mprice9/Raspberry-PIC-GoPack/README.md

# RaspberryPIC GoPack
A Rapsberry Pi powered prototyping platform for wearable robotics and data acquisition.
