mprice9/Raspberry-PIC-GoPack/GoPack Board Rev A/Pi MCU shield.brd

## EAGLE design GoPack Board Rev A/Pi MCU shield.brd (2017-01-17)

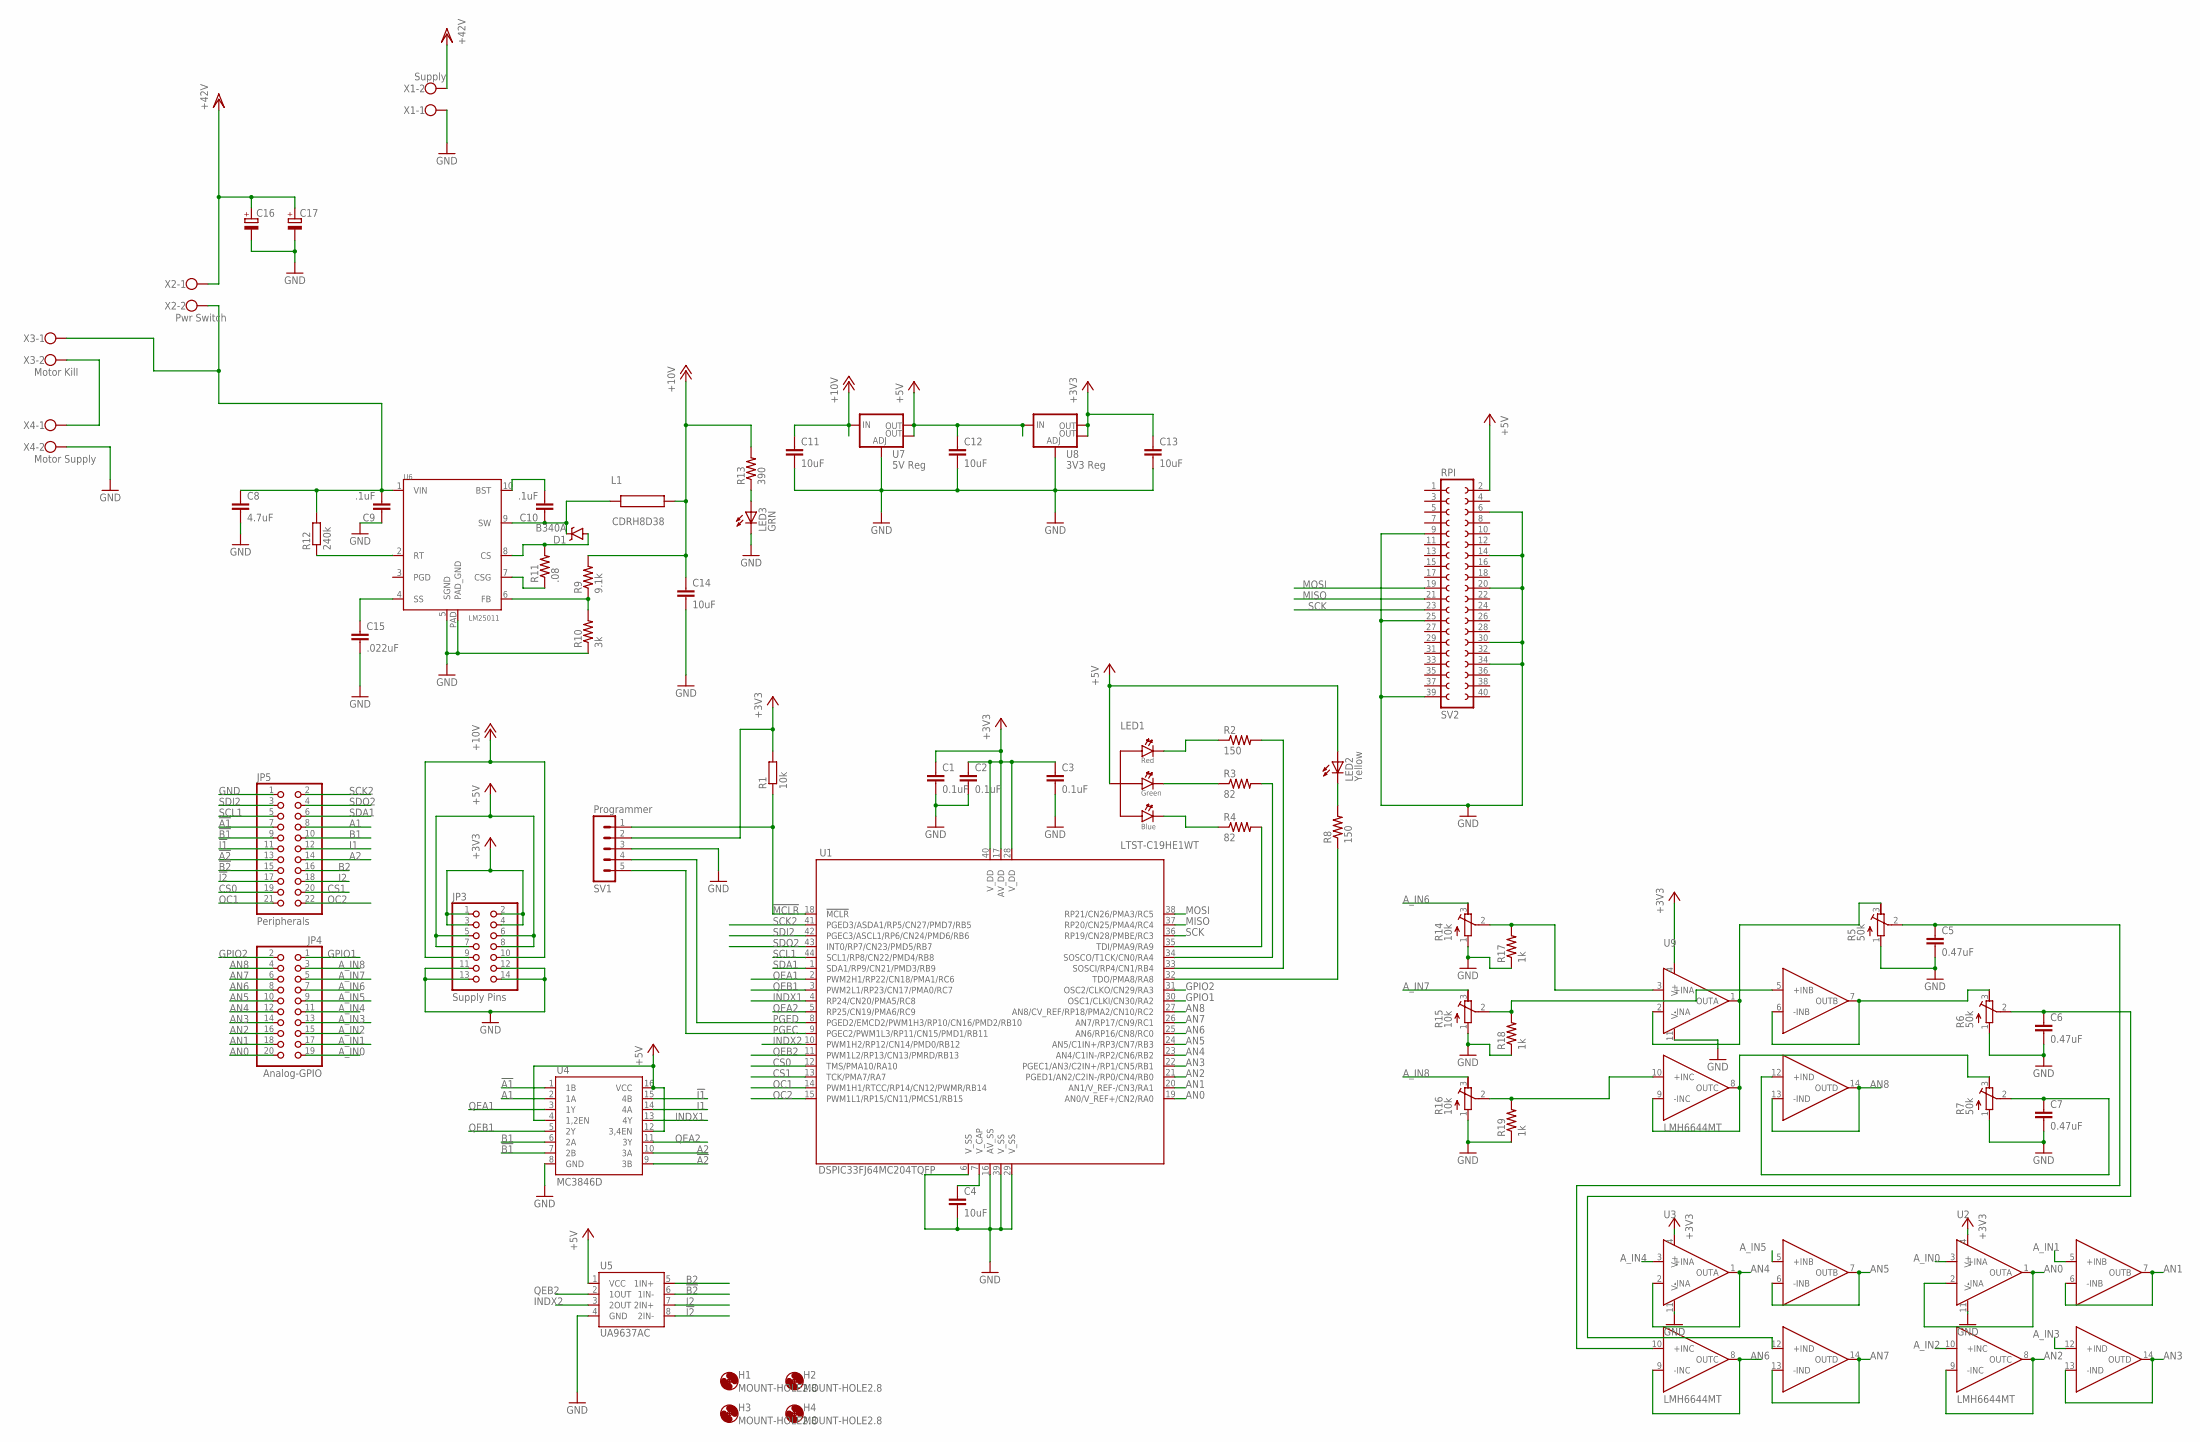
[picture p1: schematic Pi MCU shield.sch]

Parts:
C1, C2, C3: 0.1uF; C0603
C4, C14: 10uF; C1206
C5, C6, C7: 0.47uF; C0603
C8: 4.7uF; C1210
C9, C10: .1uF; 0603-CAP
C11, C12, C13: 10uF; C0805
C15: .022uF; 0603-CAP
C16, C17: CPOL-EUE5-13; E5-13
D1: B340A; SMA-DIODE
H1, H2, H3, H4: MOUNT-HOLE2.8; 2,8
JP3: Supply Pins; 2X07
JP4: Analog-GPIO; 2X10
JP5: Peripherals; 2X11
L1: CDRH8D38
LED1: LTST-C19HE1WT; 0606
LED2: Yellow; SML0603
LED3: GRN; CHIP-LED0805
R1: 10k; R0805
R2, R8: 150; R0603
R3, R4: 82; R0603
R5, R6, R7: 50k; RTRIM3224J
R9: 9.1k; 0603-RES
R10: 3k; 0603-RES
R11: .08; 0603-RES
R12: 240k; R0805
R13: 390; 0603-RES
R14, R15, R16: 10k; RTRIM3224J
R17, R18, R19: 1k; R0603
SV1: Programmer; MA05-1
SV2: RPI; FE20-2
U1: DSPIC33FJ64MC204TQFP; TQFP44
U2, U3, U9: LMH6644MT; TSSOP14
U4: MC3846D; SO-16
U5: UA9637AC; SO-08
U6: LM25011; HVSS0P-10
U7: 5V Reg; SOT223
U8: 3V3 Reg; SOT223
X1: Supply; W237-102
X2: Pwr Switch; W237-102
X3: Motor Kill; W237-102
X4: Motor Supply; W237-102

Connections:
!A1: JP5.7, U4.1 (1B)
!A2: JP5.13, U4.9 (3B)
!B1: JP5.9, U4.7 (2B)
!B2: JP5.15, U5.6 (1IN-)
!I1: JP5.11, U4.15 (4B)
!I2: JP5.17, U5.8 (2IN-)
!MCLR: R1.1, SV1.1, U1.18 (!MCLR)
+3V3: C1.1, C2.1, C3.1, C13.1, JP3.1, JP3.2, JP3.3, JP3.4, R1.2, SV1.2, U1.17 (AV_DD), U1.28 (V_DD), U1.40 (V_DD), U2.4 (V+), U3.4 (V+), U8.2 (OUT), U8.4 (OUT), U9.4 (V+)
+5V: C12.1, JP3.5, JP3.6, JP3.7, JP3.8, LED1.4 (ANODE), LED2.A, SV2.2, U4.4 (1,2EN), U4.12 (3,4EN), U4.16 (VCC), U5.1 (VCC), U7.2 (OUT), U7.4 (OUT), U8.3 (IN)
+10V: C11.1, C14.1, JP3.9, JP3.10, L1.P$2 (2), R9.2, R13.2, U7.3 (IN)
A1: JP5.8, U4.2 (1A)
A2: JP5.14, U4.10 (3A)
AN0: JP4.20, U1.19 (AN0/V_REF+/CN2/RA0), U2.1 (OUTA), U2.2 (-INA)
AN1: JP4.18, U1.20 (AN1/V_REF-/CN3/RA1), U2.6 (-INB), U2.7 (OUTB)
AN2: JP4.16, U1.21 (PGED1/AN2/C2IN-/RP0/CN4/RB0), U2.8 (OUTC), U2.9 (-INC)
AN3: JP4.14, U1.22 (PGEC1/AN3/C2IN+/RP1/CN5/RB1), U2.13 (-IND), U2.14 (OUTD)
AN4: JP4.12, U1.23 (AN4/C1IN-/RP2/CN6/RB2), U3.1 (OUTA), U3.2 (-INA)
AN5: JP4.10, U1.24 (AN5/C1IN+/RP3/CN7/RB3), U3.6 (-INB), U3.7 (OUTB)
AN6: JP4.8, U1.25 (AN6/RP16/CN8/RC0), U3.8 (OUTC), U3.9 (-INC)
AN7: JP4.6, U1.26 (AN7/RP17/CN9/RC1), U3.13 (-IND), U3.14 (OUTD)
AN8: JP4.4, U1.27 (AN8/CV_REF/RP18/PMA2/CN10/RC2), U9.13 (-IND), U9.14 (OUTD)
A_IN0: JP4.19, U2.3 (+INA)
A_IN1: JP4.17, U2.5 (+INB)
A_IN2: JP4.15, U2.10 (+INC)
A_IN3: JP4.13, U2.12 (+IND)
A_IN4: JP4.11, U3.3 (+INA)
A_IN5: JP4.9, U3.5 (+INB)
A_IN6: JP4.7, R14.3 (E)
A_IN7: JP4.5, R15.3 (E)
A_IN8: JP4.3, R16.3 (E)
B1: JP5.10, U4.6 (2A)
B2: JP5.16, U5.5 (1IN+)
BLUE: LED1.2 (G_CATHODE), R3.1
CS0: JP5.19, U1.12 (TMS/PMA10/RA10)
CS1: JP5.20, U1.13 (TCK/PMA7/RA7)
GND: C1.2, C2.2, C3.2, C4.2, C5.2, C6.2, C7.2, C8.2, C9.1, C11.2, C12.2, C13.2, C14.2, C15.2, C16.-, C17.-, JP3.11, JP3.12, JP3.13, JP3.14, JP5.1, LED3.C, R5.1 (A), R6.1 (A), R7.1 (A), R10.1, R14.1 (A), R15.1 (A), R16.1 (A), R17.1, R18.1, R19.1, SV1.3, SV2.6, SV2.9, SV2.14, SV2.20, SV2.25, SV2.30, SV2.34, SV2.39, U1.6 (V_SS), U1.16 (AV_SS), U1.29 (V_SS), U1.39 (V_SS), U2.11 (V-), U3.11 (V-), U4.8 (GND), U5.4 (GND), U6.5 (SGND), U6.PAD (PAD_GND), U7.1 (ADJ), U8.1 (ADJ), U9.11 (V-), X1.1, X4.2
GPIO1: JP4.1, U1.30 (OSC1/CLKI/CN30/RA2)
GPIO2: JP4.2, U1.31 (OSC2/CLKO/CN29/RA3)
GREEN: LED1.3 (B_CATHODE), R4.1
I1: JP5.12, U4.14 (4A)
I2: JP5.18, U5.7 (2IN+)
INDX1: U1.4 (RP24/CN20/PMA5/RC8), U4.13 (4Y)
INDX2: U1.10 (PWM1H2/RP12/CN14/PMD0/RB12), U5.3 (2OUT)
MISO: SV2.21, U1.37 (RP20/CN25/PMA4/RC4)
MOSI: SV2.19, U1.38 (RP21/CN26/PMA3/RC5)
unnamed: R15.2 (S), R18.2, U9.5 (+INB)
unnamed: C4.1, U1.7 (V_CAP)
unnamed: C8.1, C9.2, R12.2, U6.1 (VIN), X2.2, X3.1
unnamed: C7.1, R7.2 (S), U9.12 (+IND)
unnamed: C5.1, R5.2 (S), U3.10 (+INC)
unnamed: X3.2, X4.1
unnamed: R14.2 (S), R17.2, U9.3 (+INA)
unnamed: R6.3 (E), U9.6 (-INB), U9.7 (OUTB)
unnamed: R7.3 (E), U9.8 (OUTC), U9.9 (-INC)
unnamed: LED3.A, R13.1
unnamed: LED2.C, R8.2
unnamed: R4.2, U1.35 (TDI/PMA9/RA9)
unnamed: R3.2, U1.34 (SOSCO/T1CK/CN0/RA4)
unnamed: R2.2, U1.33 (SOSCI/RP4/CN1/RB4)
unnamed: R16.2 (S), R19.2, U9.10 (+INC)
unnamed: R8.1, U1.32 (TDO/PMA8/RA8)
unnamed: C10.1, D1.C, L1.P$1 (1), U6.9 (SW)
unnamed: R9.1, R10.2, U6.6 (FB)
unnamed: R12.1, U6.2 (RT)
unnamed: C15.1, U6.4 (SS)
unnamed: D1.A, R11.2, U6.8 (CS)
unnamed: C10.2, U6.10 (BST)
unnamed: R11.1, U6.7 (CSG)
unnamed: R5.3 (E), U9.1 (OUTA), U9.2 (-INA)
unnamed: C6.1, R6.2 (S), U3.12 (+IND)
OC1: JP5.21, U1.14 (PWM1H1/RTCC/RP14/CN12/PWMR/RB14)
OC2: JP5.22, U1.15 (PWM1L1/RP15/CN11/PMCS1/RB15)
PGEC: SV1.5, U1.9 (PGEC2/PWM1L3/RP11/CN15/PMD1/RB11)
PGED: SV1.4, U1.8 (PGED2/EMCD2/PWM1H3/RP10/CN16/PMD2/RB10)
QEA1: U1.2 (PWM2H1/RP22/CN18/PMA1/RC6), U4.3 (1Y)
QEA2: U1.5 (RP25/CN19/PMA6/RC9), U4.11 (3Y)
QEB1: U1.3 (PWM2L1/RP23/CN17/PMA0/RC7), U4.5 (2Y)
QEB2: U1.11 (PWM1L2/RP13/CN13/PMRD/RB13), U5.2 (1OUT)
RED: LED1.1 (R_CATHODE), R2.1
SCK: SV2.23, U1.36 (RP19/CN28/PMBE/RC3)
SCK2: JP5.2, U1.41 (PGED3/ASDA1/RP5/CN27/PMD7/RB5)
SCL1: JP5.5, U1.44 (SCL1/RP8/CN22/PMD4/RB8)
SDA1: JP5.6, U1.1 (SDA1/RP9/CN21/PMD3/RB9)
SDI2: JP5.3, U1.42 (PGEC3/ASCL1/RP6/CN24/PMD6/RB6)
SDO2: JP5.4, U1.43 (INT0/RP7/CN23/PMD5/RB7)
VDD: C16.+, C17.+, X1.2, X2.1

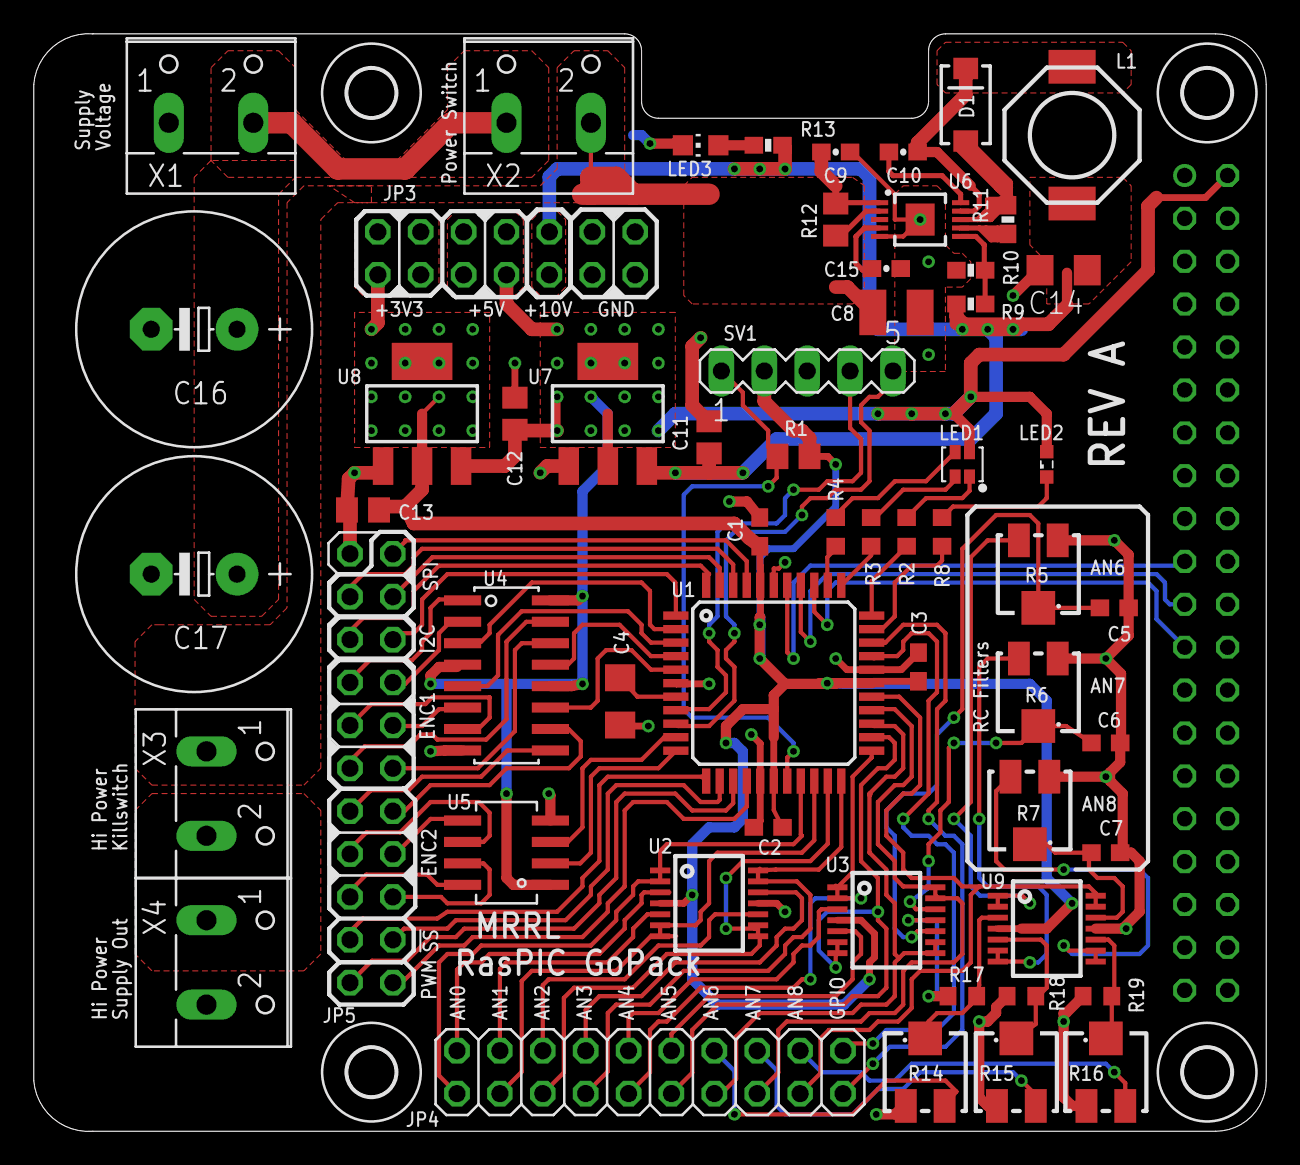
[picture p2: board Pi MCU shield.brd from above]

Board: 2 copper layers, 73.0 x 65.0 mm, 63 parts (1 on the bottom side), 86 nets.
