mprice9/Raspberry-PIC-GoPack/PIC code/10-13-16 spi broken/main.c

/******************************************************************
Name: main.c
Author: Mark Price
Date: 5/9/2016

INCLUDE FILES: p33FJ64MC204.h, p33FJ64MC204.gld (Linker Script),
functions.c, support.h
******************************************************************/
#define FCY 40000000UL

#include "p33FJ64MC204.h" 	//Include p33FJ64MC202 header file
#include <math.h>			//Include math libary
#include "support.h" 		//Include Defitions and function prototypes
#include <stdio.h>
#include <stdlib.h>
#include "libpic30.h"		//FCY must be defined before libpic30.h is included

////////////////////////////////////////////////////////////////////////////////////////////
// Global variable declarations
////////////////////////////////////////////////////////////////////////////////////////////

// Initialization/runtime variables
long int run_time = 0;			// 1 msec increments, resets at 2^16 msec
float period;
int wait_flag = 0;				// signal for end of sample time
float samp_time = 1; 			// milliseconds
float p;
int pwm1_duty_12bit;
int pwm1_duty;
int pwm2_duty;
int num_ADC;
extern short oc1flag;

// Hall Effect Sensor variables (force, ang position)
float steeringAngle;
float fMag;
float fAngle;
double xDisp;
double yDisp;
double forceX;
double forceY;
int Bx;
int By;
int Bz;
int vg;
unsigned int zVal;
unsigned int xVal;
unsigned int yVal;
unsigned int alpha;
float k;
int hallErrorFlag;

// Encoder variables
//int enc1_res = 4096; // # pulses x 4 (quadrature)
//int enc2_res = 4096;
float enc1_pos = 0;
float enc2_pos = 0;
extern short enc1flag;

unsigned int dataIn[RASPI_BUF_SIZE];
unsigned int dataOut[RASPI_BUF_SIZE];

// SPI communication variables
int spi1_flag;
int spi2_flag;
int SPI_wait_flag;
extern short rasPiErrFlag;

// ADC variables
int ain0Buff[SAMP_BUFF_SIZE];
int ain1Buff[SAMP_BUFF_SIZE];
int ain2Buff[SAMP_BUFF_SIZE];
int ain3Buff[SAMP_BUFF_SIZE];
int ain4Buff[SAMP_BUFF_SIZE];
int ain5Buff[SAMP_BUFF_SIZE];
int ain6Buff[SAMP_BUFF_SIZE];
int ain7Buff[SAMP_BUFF_SIZE];
int ain8Buff[SAMP_BUFF_SIZE];
int sampleCounter = 0;
int scanCounter = 0;

/////////////////////////////////////////////////////////////////
// Start Main Function
/////////////////////////////////////////////////////////////////

int main()
{

//Initialization Routines
init_clock();			// initialize Clock 80 MHz/40 MIPS
init_pins();			// initialize pins
init_samptime();		// initialize sample time

//Set up SPI (slave - RasPi, master - peripherals)
init_spi1_buff();
init_spi1();            // slave
init_dma0_spi1_tx();
init_dma1_spi1_rx();
//init_spi2();            // master

//Set up encoders
//init_encoder1();
//init_encoder2();

//Set up I2C
//init_i2c();

//Set up output compare (PWM)
//init_pwm1();            // Tied to Timer 2
//init_pwm2();            // Timer 2 or Timer 3

//Set up analog inputs
//initTmr3();
//initDMA_ADC();
//init_ADC();

//Local variables in main

RGB_R = 1;
RGB_G = 1;
RGB_B = 1;
LED_Y = 1;

while(1)
{

      
//    if(run_time % 1000 == 0){
//            LED_Y = (run_time/1000) % 2;
//    }
    
//    pwm1_duty = 500;
//    pwm2_duty = 250;
    
//    if(rasPiErrFlag != 0) rasPiErrFlag = 0;
//    
//   // processRXdata();
//    
//    if ((dataOut[2] & 0x0F) != 2){
//        rasPiErrFlag = 1;
//    }
//    else rasPiErrFlag = 0;
    
	while(SPI_wait_flag == 0){  	// Waits for sample time before looping, enforces constant 1.5 ms sample time
//        MOT_D1=1;
    }
 //   MOT_D1=0;
    SPI_wait_flag = 0;				// reset wait flag
}
return 0;
} // end main
